desiFish/Smart-Aquarium-V3.1/(threads)

Thread 2 (2025-06-26):

Need a reset button

desiFish, 2025-06-26:
Physical button for reset everything

Closed 2025-07-21.

Thread 8 (2025-07-22):

LED Error Codes

desiFish, 2025-07-22:
Implement better LED based error codes.

Closed 2025-07-22.
