desiFish/Smart-Aquarium-V3.1/(commit log)

2025-06-05 esp32 version linked
2025-06-25 UI related updates
    - updated default ntp pool to India
    - updated copyright symbol
    - update LED to Relay in some places index.html
    - updated readme about NTP
2025-06-26 Major Update v1.1.0
    There is a Wi-Fi manager now. The device sets up the server at 192.168.4.1 on the first run. Go to settings and set up.
    Settings Page now has:
    Backup Button: Downloads all the configurations to your PC/Smartphone in a simple JSON file
    Restore Button: Restore the configuration/setting from the Downloaded Backup JSON file
    Both these buttons have a loading animation for a better User experience
    WiFi setting: Now set the WiFi SSID and Password directly
    Set Static IP
    NTP settings like timezone and NTP server
    A clock that shows RTC time (every 30 seconds refresh)
    Other bugs fixed
    Updates in some documentation areas
    [Smart-Aquarium-V3_1.ino]
2025-06-28 Minor Update v1.1.2
    Changes:
    1. Index.html: Added error polling function to fetch error messages from backend (if any, whenever occurs)
    2. settings.html:
    * Added danger symbol with tooltip for reboot required buttons
    * NTP related settings will provided detailed info, now also requires reboot.
    * Added error polling function to fetch error messages from backend (if any, whenever occurs)
    3. specs.html: Added error polling function to fetch error messages from backend (if any, whenever occurs)
    4. Main program:
    * bumped program version to v1.1.2
    * minor debug updates
    * relays are by default disabled now (during fresh setup only)
    * after NTP update, system will auto update rtc after reboot; ne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
    [Smart-Aquarium-V3_1.ino]
2025-07-21 Enhance CH340 driver troubleshooting section for clarity and emphasis
2025-07-22 Refactor LED handling during OTA updates and WiFi connection for improved visual feedback
2025-07-22 issue #7 for v1.1.6
    [Smart-Aquarium-V3_1.ino]
2025-07-28 Fix WiFi/AP mode LED indication in README.md
2025-07-28 Fix WiFi/AP mode LED indication description in README.md
2026-02-18 json bug fix + rtc update auto
    [Smart-Aquarium-V3_1.ino]
