desiFish/Smart-Aquarium-V3.1/(notices)

Notices in the files:
Smart-Aquarium-V3_1.ino:
This program is free software under GPL v3: you can:
- Use it for any purpose
- Share any modifications under the same license
README.md:
License: GPL v3
